elaine-ch/quadcopter/README.md

## Vortex 2024 Drone project


Video of it flying: [https://photos.app.goo.gl/hCnUwj7Pyiz6dDBa6](https://photos.app.goo.gl/hCnUwj7Pyiz6dDBa6)
