elaine-ch/quadcopter/hardware/quadcopter.brd

## EAGLE design hardware/quadcopter.brd (2024-11-07)

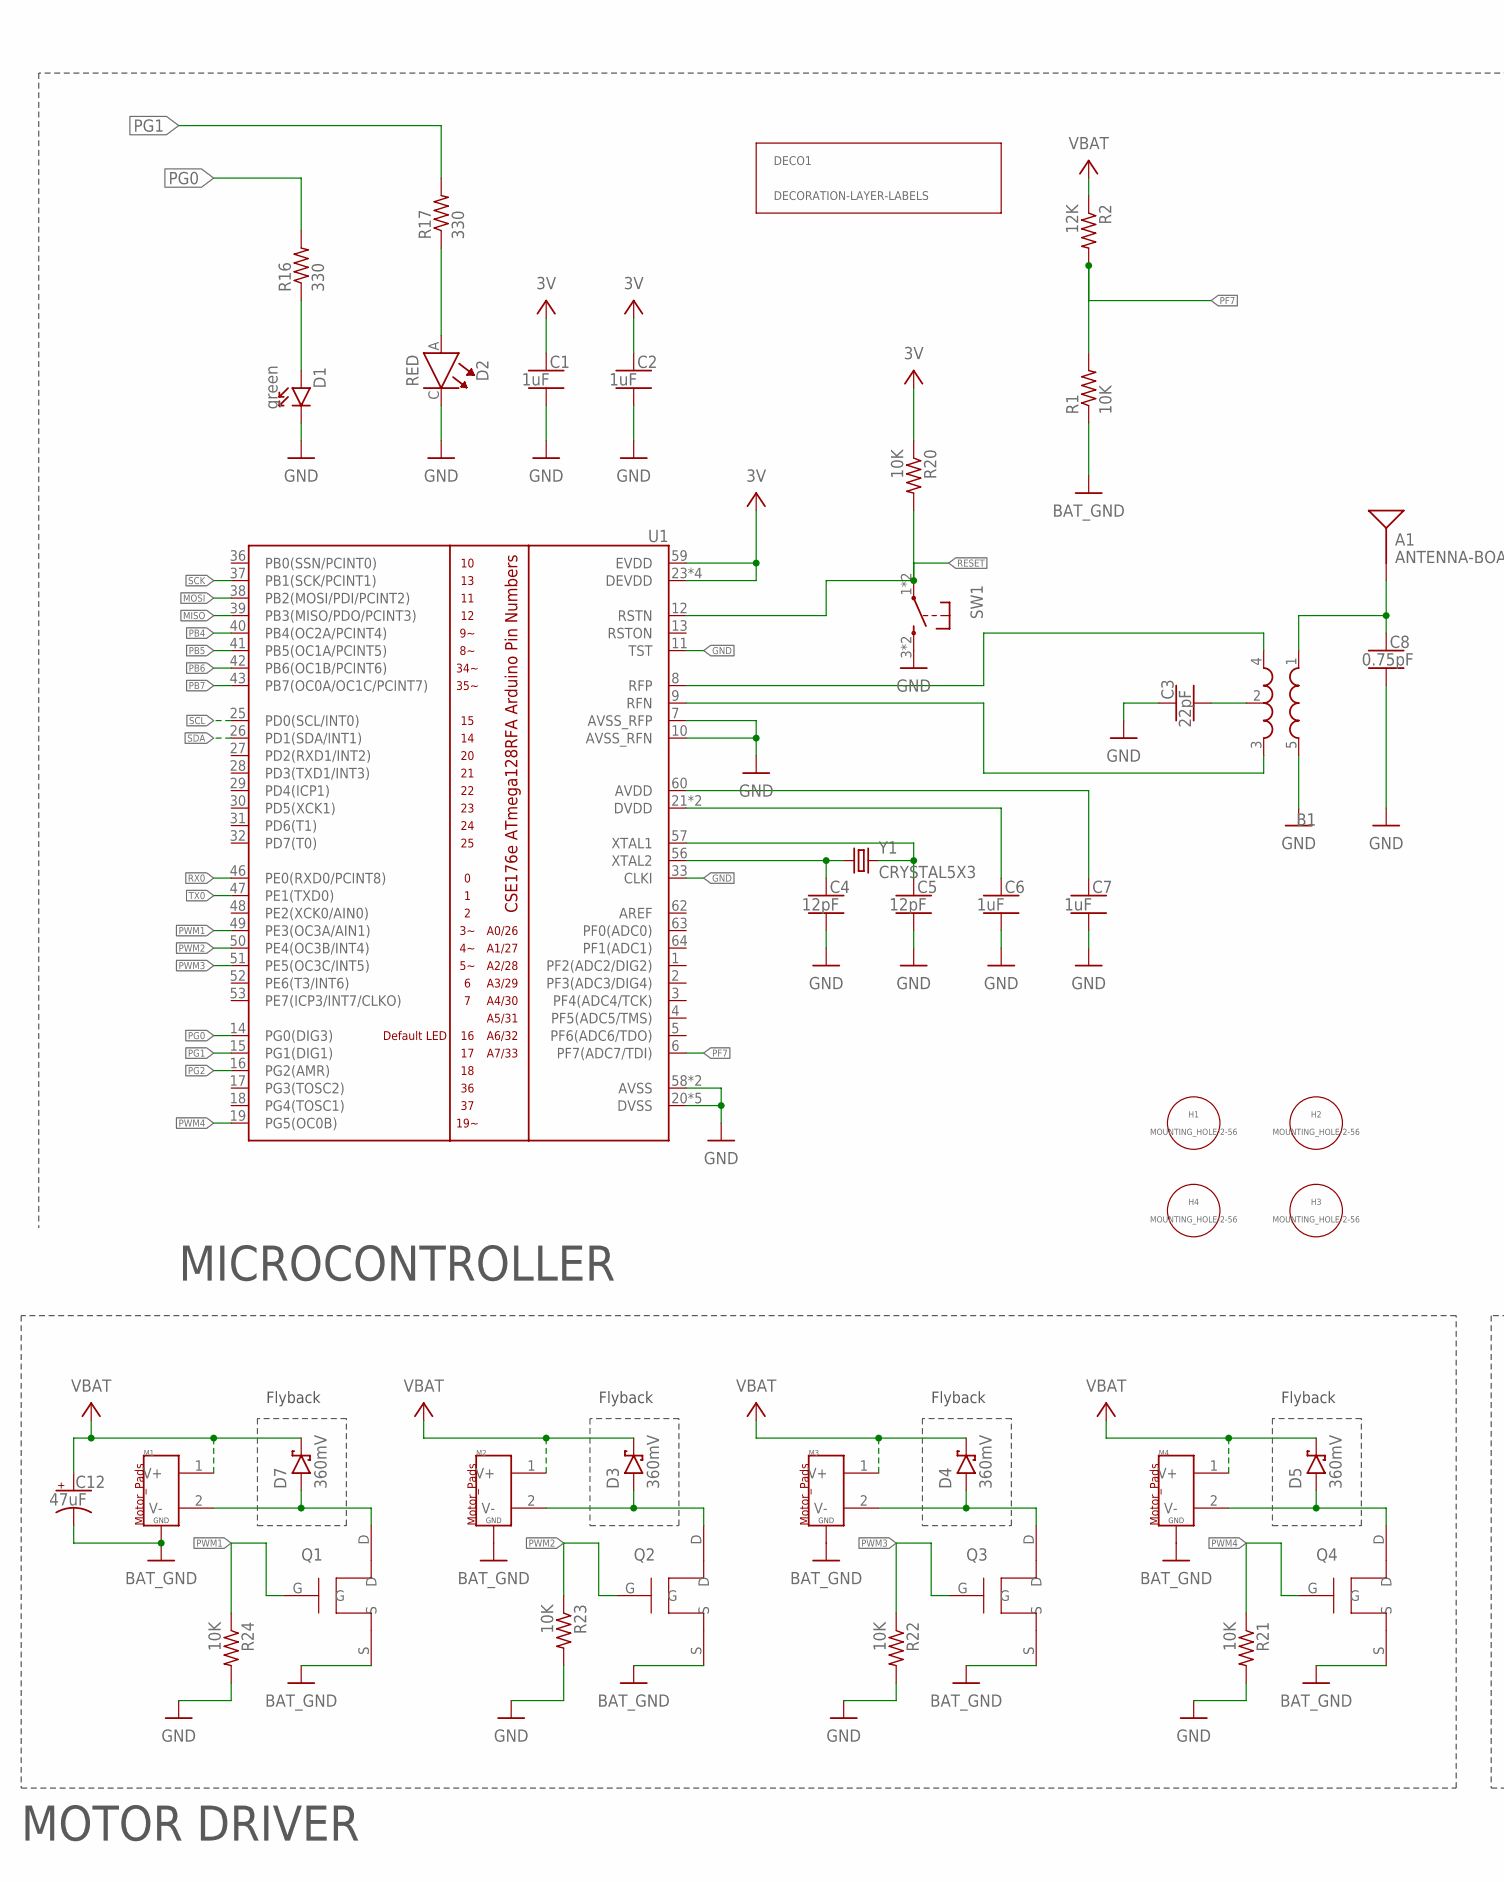
[picture p1: schematic quadcopter.sch, part in row 1, column 1]

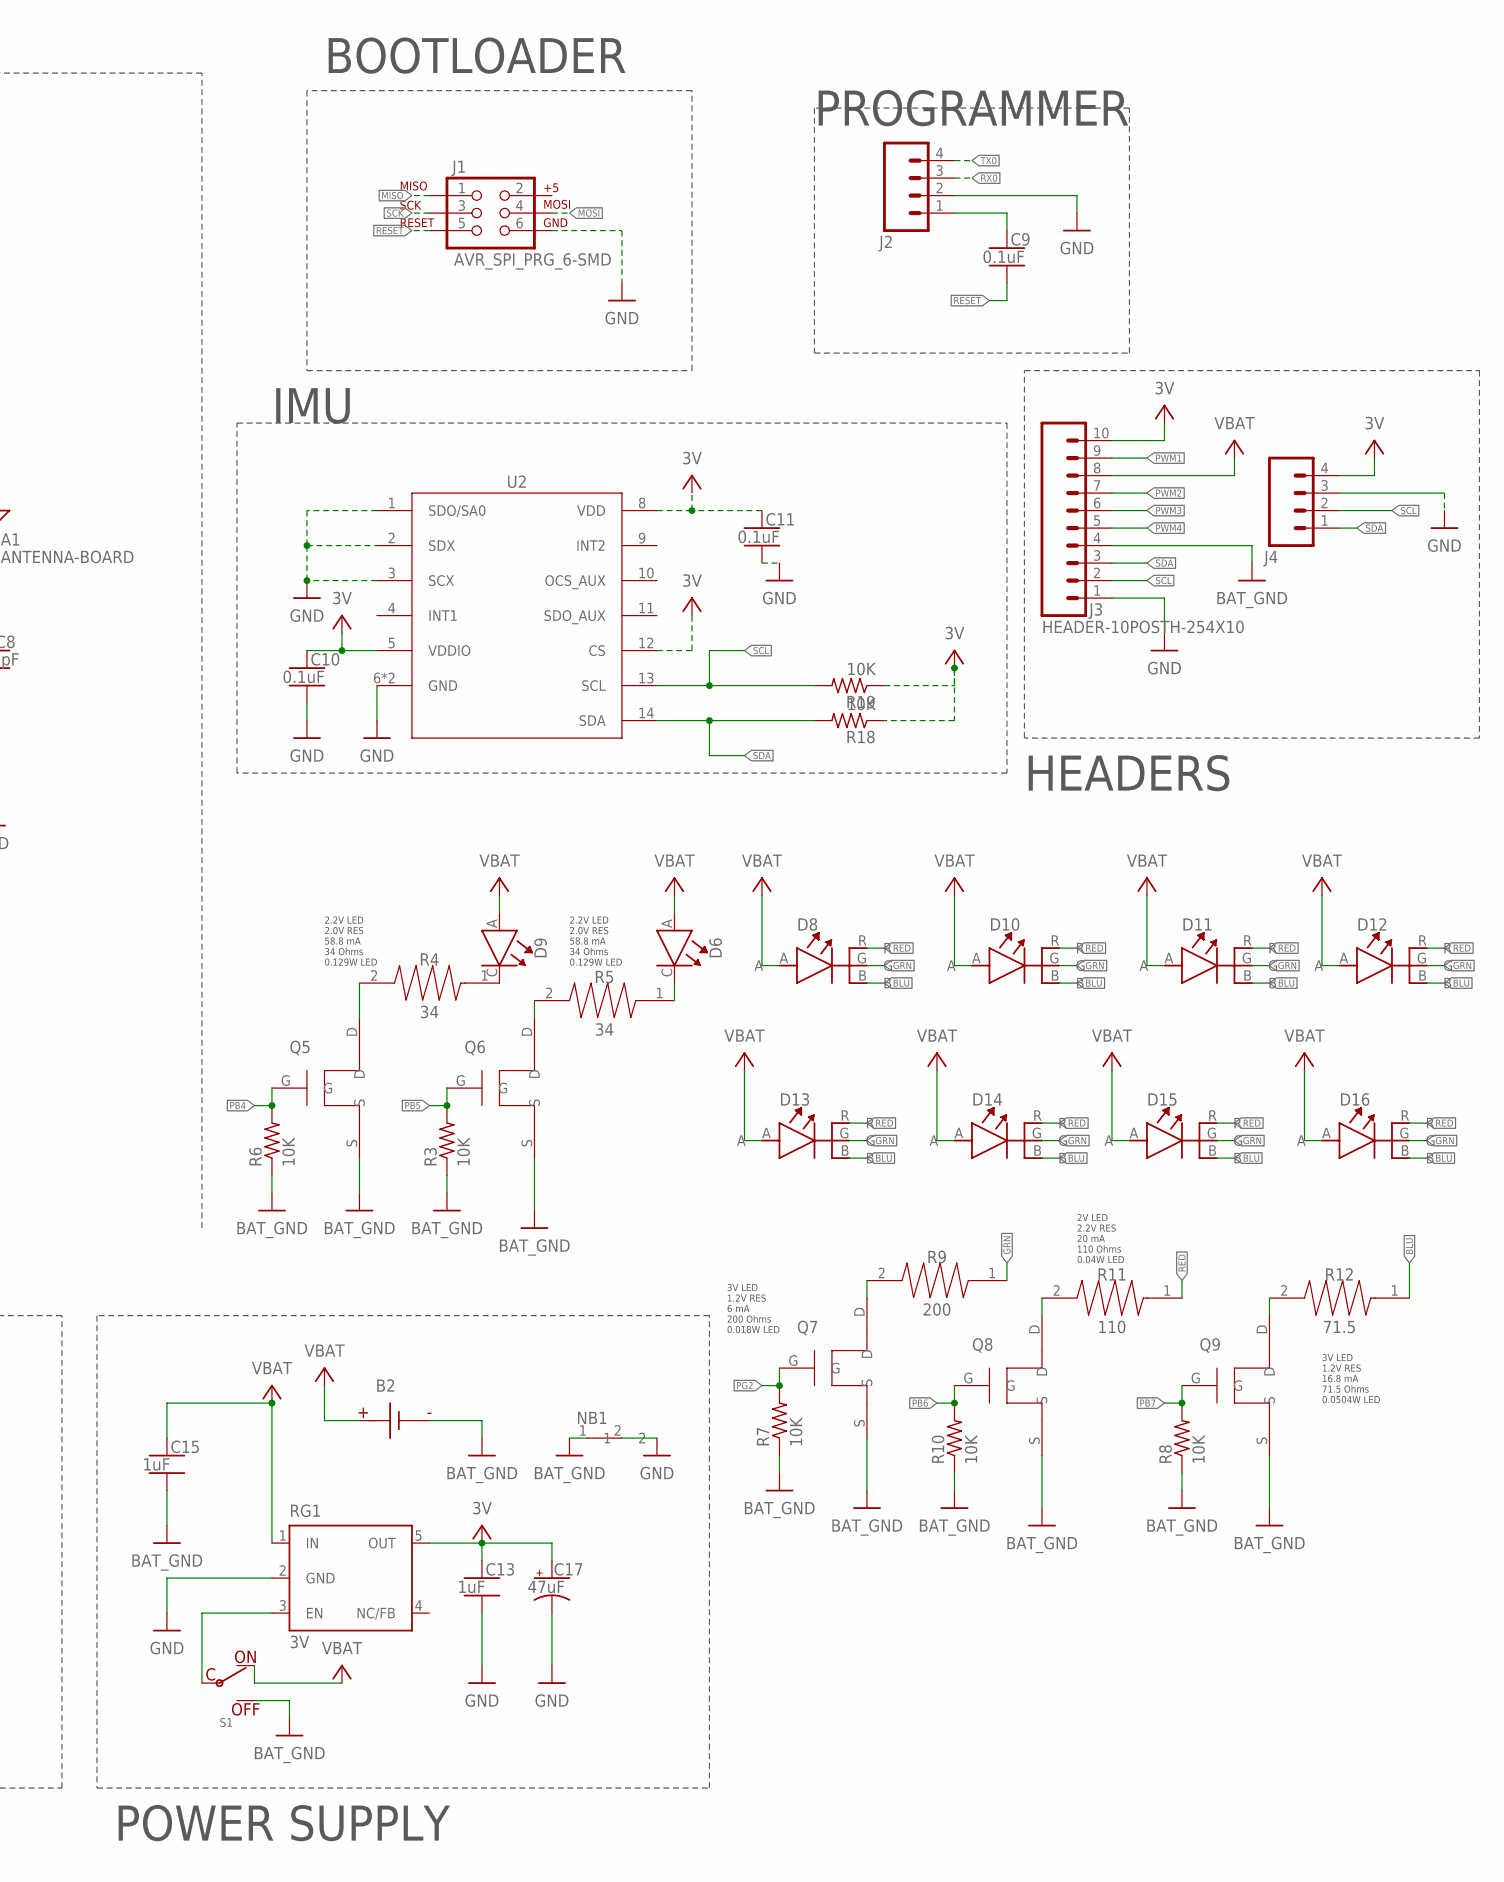
[picture p2: schematic quadcopter.sch, part in row 1, column 2]

Parts:
A1: ANTENNA-BOARD; ANT_PCB_2.4GHZ_NRF8001_1.6MM_1OZ
B1: BALUN0805; BALUN
B2: BATTERY-SCREW-TERMINAL; SCREW-TERMINAL-1X2-2.54MM
C1, C2, C6, C7, C13, C15: 1uF; CAPC2012X140_HS
C3: 22pF; CAPC2012X140_HS
C4, C5: 12pF; CAPC2012X140_HS
C8: 0.75pF; CAPC2012X140_HS
C9, C10, C11: 0.1uF; CAPC2012X140_HS
C12, C17: 47uF; CAPMP3216X180
D1: green; LEDSC125X200X120-2_HS
D2: RED; LEDC1507X80
D3, D4, D5, D7: 360mV; SODFL3516X96
D6, D9: LED-YELLOW-LED; LEDQLSP30YK
D8, D10, D11, D12, D13, D14, D15, D16: RGB-LED-DIFFUSE-LED; LED150080M153000
DECO1: DECORATION-LAYER-LABELS; LAYER_LABELS
H1, H2, H3, H4: MOUNTING_HOLE-2-56; 2-56-MOUNTING-HOLE-NO-METAL
J1: AVR_SPI_PRG_6-SMD; 2X3-SMD
J2, J4: HEADER-4POS-0.1IN-FEMALE-SMD-BOTTOM-ENTRY; HEADER-1X4-BOTTOM-ENTRY
J3: HEADER-10POSTH-254X10; HDRV10W63P254_10X1_2540X254H838_HS
M1, M2, M3, M4: MOTOR_PADS_GND-MOLEX-SMD; MOLEX-0532610271
NB1: NET-BRIDGE; NET_BRIDGE
Q1, Q2, Q3, Q4, Q5, Q6, Q7, Q8, Q9: MOSFET-SI2302CDS-T1-E3CT-ND; SOT95P240X110-3MOSFET
R1, R3, R6, R7, R8, R10, R18, R19, R20, R21, R22, R23, R24: 10K; RESC2012X60_HS
R2: 12K; RESC2012X60_HS
R4, R5: 34; 0805_RESISTOR
R9: 200; 0805_RESISTOR
R11: 110; 0805_RESISTOR
R12: 71.5; 0805_RESISTOR
R16, R17: 330; RESC2012X60_HS
RG1: 3V; SOT23-DBV
S1: POWER-SWITCH-MFS201N-9-Z-SMD-EDGE; JS102011SAQN
SW1: PUSHBUTTON_SMD-VERTICAL-1; TE_FSM8JSMA_HS
U1: ATMEGA128RFA1; QFN-64
U2: LSM-IMU-497-18367-1-NDIMU; LSM6DS0-IMU
Y1: CRYSTAL5X3; CRYSTAL-SMD-5X3

Connections:
3V: C1.1, C2.1, C10.1, C11.1, C13.1, C17.1 (+), J3.10, J4.4, R18.1, R19.1, R20.1, RG1.5 (OUT), U1.23 (DEVDD), U1.34 (DEVDD), U1.44 (DEVDD), U1.54 (DEVDD), U1.59 (EVDD), U2.5 (VDDIO), U2.8 (VDD), U2.12 (CS)
BAT_GND: B2.1 (N), C12.2 (-), C15.2, J3.4, M1.G1 (GND), M1.G2 (GND), M2.G1 (GND), M2.G2 (GND), M3.G1 (GND), M3.G2 (GND), M4.G1 (GND), M4.G2 (GND), NB1.1, Q1.S, Q2.S, Q3.S, Q4.S, Q5.S, Q6.S, Q7.S, Q8.S, Q9.S, R1.1, R3.1, R6.1, R7.1, R8.1, R10.1, S1.A (OFF)
BLU: D8.B, D10.B, D11.B, D12.B, D13.B, D14.B, D15.B, D16.B, R12.1
GND: B1.5 (GND), C1.2, C2.2, C3.1, C4.2, C5.2, C6.2, C7.2, C8.2, C10.2, C11.2, C13.2, C17.2 (-), D1.C, D2.C, J1.6, J2.2, J3.1, J4.3, NB1.2, R21.2, R22.2, R23.2, R24.2, RG1.2 (GND), SW1.3 (2), SW1.4 (2), U1.7 (AVSS_RFP), U1.10 (AVSS_RFN), U1.11 (TST), U1.20 (DVSS), U1.24 (DVSS), U1.33 (CLKI), U1.35 (DVSS), U1.45 (DVSS), U1.55 (DVSS), U1.58 (AVSS), U1.61 (AVSS), U2.1 (SDO/SA0), U2.2 (SDX), U2.3 (SCX), U2.6 (GND), U2.7 (GND)
GRN: D8.G, D10.G, D11.G, D12.G, D13.G, D14.G, D15.G, D16.G, R9.1
MISO: J1.1, U1.39 (PB3(MISO/PDO/PCINT3))
MOSI: J1.4, U1.38 (PB2(MOSI/PDI/PCINT2))
unnamed: D1.A, R16.1
unnamed: D2.A, R17.1
unnamed: B1.4 (OUT1), U1.8 (RFP)
unnamed: B1.3 (OUT2), U1.9 (RFN)
unnamed: B1.2 (GND), C3.2
unnamed: C5.1, U1.57 (XTAL1), Y1.3 (2)
unnamed: C4.1, U1.56 (XTAL2), Y1.1
unnamed: C7.1, U1.60 (AVDD)
unnamed: C6.1, U1.21 (DVDD), U1.22 (DVDD)
unnamed: A1.FEED, B1.1 (IN), C8.1
unnamed: C9.1, J2.1
unnamed: D9.C, R4.1
unnamed: Q6.D, R5.2
unnamed: D7.2 (A), M1.2 (V-), Q1.D
unnamed: D3.2 (A), M2.2 (V-), Q2.D
unnamed: D4.2 (A), M3.2 (V-), Q3.D
unnamed: D5.2 (A), M4.2 (V-), Q4.D
unnamed: D6.C, R5.1
unnamed: Q7.D, R9.2
unnamed: RG1.3 (EN), S1.C
unnamed: Q8.D, R11.2
unnamed: Q5.D, R4.2
unnamed: Q9.D, R12.2
PB4: Q5.G, R6.2, U1.40 (PB4(OC2A/PCINT4))
PB5: Q6.G, R3.2, U1.41 (PB5(OC1A/PCINT5))
PB6: Q8.G, R10.2, U1.42 (PB6(OC1B/PCINT6))
PB7: Q9.G, R8.2, U1.43 (PB7(OC0A/OC1C/PCINT7))
PF7: R1.2, R2.2, U1.6 (PF7(ADC7/TDI))
PG0: R16.2, U1.14 (PG0(DIG3))
PG1: R17.2, U1.15 (PG1(DIG1))
PG2: Q7.G, R7.2, U1.16 (PG2(AMR))
PWM1: J3.9, Q1.G, R24.1, U1.49 (PE3(OC3A/AIN1))
PWM2: J3.7, Q2.G, R23.1, U1.50 (PE4(OC3B/INT4))
PWM3: J3.6, Q3.G, R22.1, U1.51 (PE5(OC3C/INT5))
PWM4: J3.5, Q4.G, R21.1, U1.19 (PG5(OC0B))
RED: D8.R, D10.R, D11.R, D12.R, D13.R, D14.R, D15.R, D16.R, R11.1
RESET: C9.2, J1.5, R20.2, SW1.1, SW1.2 (1), U1.12 (RSTN)
RX0: J2.3, U1.46 (PE0(RXD0/PCINT8))
SCK: J1.3, U1.37 (PB1(SCK/PCINT1))
SCL: J3.2, J4.2, R19.2, U1.25 (PD0(SCL/INT0)), U2.13 (SCL)
SDA: J3.3, J4.1, R18.2, U1.26 (PD1(SDA/INT1)), U2.14 (SDA)
TX0: J2.4, U1.47 (PE1(TXD0))
VBAT: B2.2, C12.1 (+), C15.1, D3.1 (C), D4.1 (C), D5.1 (C), D6.A, D7.1 (C), D8.A, D9.A, D10.A, D11.A, D12.A, D13.A, D14.A, D15.A, D16.A, J3.8, M1.1 (V+), M2.1 (V+), M3.1 (V+), M4.1 (V+), R2.1, RG1.1 (IN), S1.B (ON)

Notes on the sheet:
MICROCONTROLLER
BOOTLOADER
PROGRAMMER
Flyback
MOTOR DRIVER
POWER SUPPLY
2.2V LED 2.0V RES 58.8 mA 34 Ohms 0.129W LED
IMU
HEADERS
3V LED 1.2V RES 6 mA 200 Ohms 0.018W LED
3V LED 1.2V RES 16.8 mA 71.5 Ohms 0.0504W LED
2V LED 2.2V RES 20 mA 110 Ohms 0.04W LED

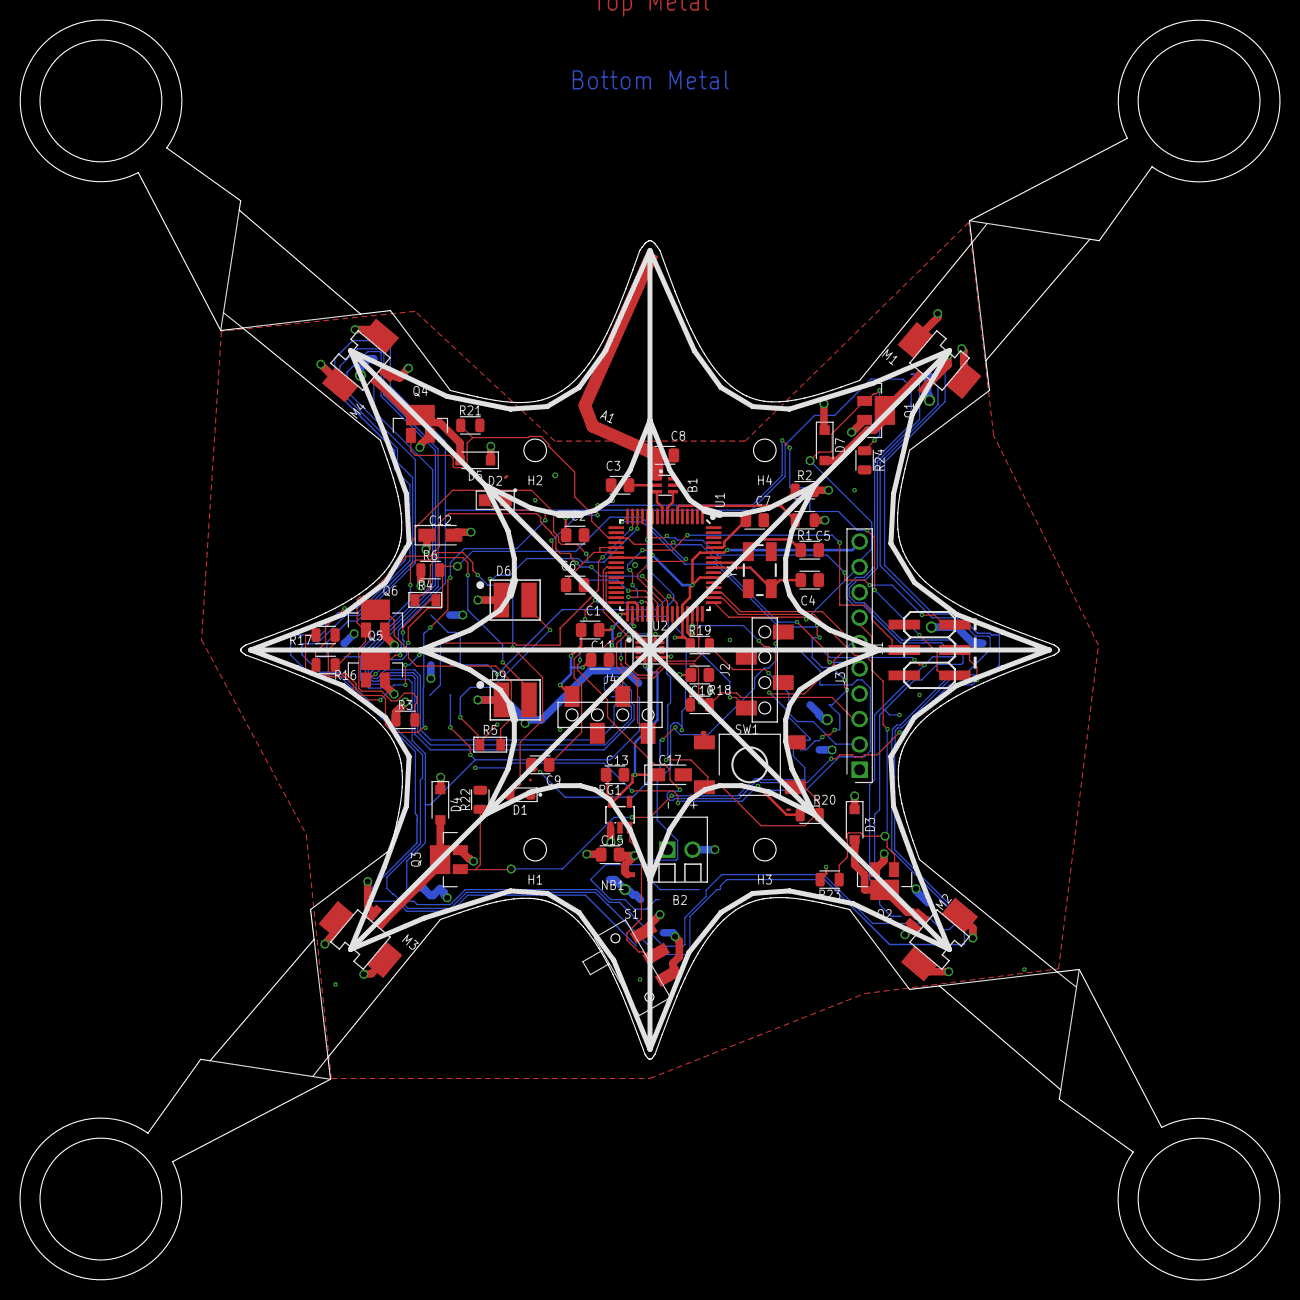
[picture p3: board quadcopter.brd from above]

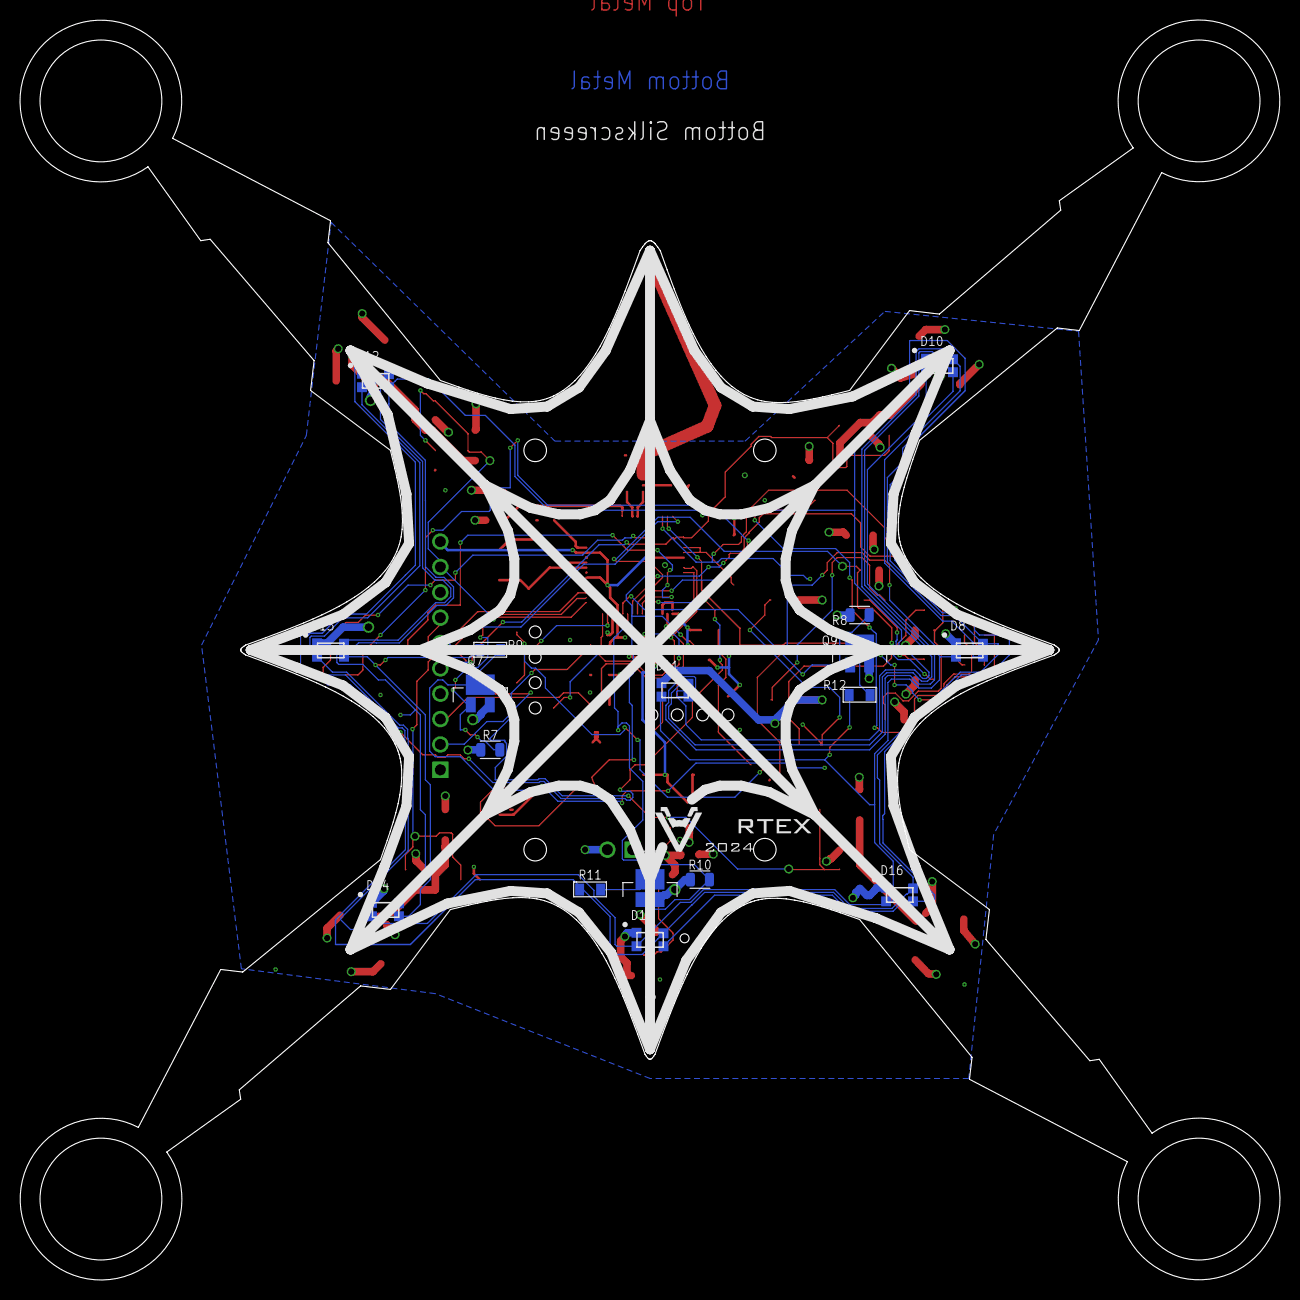
[picture p4: board quadcopter.brd from below]

Board: 4 copper layers, 126.2 x 126.2 mm, 85 parts (18 on the bottom side), 50 nets.

Other parts of the board:
LG1: VORTEX-LOGO
