elaine-ch/quadcopter/firmware/RFChat/RFChat.ino

#include "radio.h"

void setup()
{
  Serial.begin(9600);  // Start up serial
  rfBegin(12);  // Initialize ATmega128RFA1 radio on channel 11 (can be 11-26)
  
  // Send a message to other RF boards on this channel
  rfPrint("ATmega128RFA1 Dev Board Online!\r\n");
}

void loop()
{
  uint8_t b[256];
  int len;
  if (len = rfAvailable())  // If serial comes in...
  {
    rfRead(b, len);
    b[len] = 0;
    Serial.write((char *)b);
  }

  if (len = Serial.available()) {
    for (int i = 0; i < len; i++) {
      b[i] = Serial.read(); 
    }
    rfWrite(b, len); // ...send it out the radio.
  }
}
