elaine-ch/quadcopter/(commit log)

2024-10-10 added throttle serial print
2024-10-15 fixed battery levels
2024-10-15 display battery levels on LCD
2024-10-17 Lab 3
    [quadcopter_v18.sch]
2024-10-18 tried fixing the warnings
    [quadcopter.sch]
2024-10-18 updated libraries and renamed custom for submit
    [quadcopter.sch]
2024-10-18 removed extra pins
    [quadcopter.sch]
2024-10-18 switched gnd to gnd and removed VDDIO tag
    [quadcopter.sch]
2024-10-18 renamed motors
    [quadcopter.sch]
2024-10-18 fixed vddio capacitance
    [quadcopter.sch]
2024-10-18 IMU capacitances fixed?
    [quadcopter.sch]
2024-10-18 renamed net bridge
    [quadcopter.sch]
2024-10-18 fixed power supply?
    [quadcopter.sch]
2024-10-18 fixed VDDIO error hopefully
    [quadcopter.sch]
2024-10-18 attempt to fix power supply
    [quadcopter.sch]
2024-10-18 2 new resistors
    [quadcopter.sch]
2024-10-18 resistors fixed with variants
    [quadcopter.sch]
2024-10-19 changed actual library name
    [quadcopter.sch]
2024-10-19 actually made the library name changes for real this time
    [quadcopter.sch]
2024-10-19 got rid of library
    [quadcopter.sch]
2024-10-19 did git reset --hard and then exported to fix battery again
    [quadcopter.sch]
2024-10-19 changed imu connection
    [quadcopter.sch]
2024-10-19 fixed n
    [quadcopter.sch]
2024-10-19 added VDDIO connection to actual VDDIO
    [quadcopter.sch]
2024-10-19 switched pull up on SCL and SDA from 'VDDIO' to 3V
    [quadcopter.sch]
2024-10-19 moved polarized capacitor by Regulator to regulated side and made out the 3V
    [quadcopter.sch]
2024-10-19 redid VDDIO
    [quadcopter.sch]
2024-10-19 renamed motor pads because mosfet is complaining?
    [quadcopter.sch]
2024-10-19 removed 3 mosfets and motor pads
    [quadcopter.sch]
2024-10-19 replaced motors
    [quadcopter.sch]
2024-10-19 replaced motor pads and mosfets fulls
    [quadcopter.sch]
2024-10-19 replaced flyback diodes
    [quadcopter.sch]
2024-10-19 why :((
    [quadcopter.sch]
2024-10-19 renamed motor pads
    [quadcopter.sch]
2024-10-19 replaced all custom resistors and parts
    [quadcopter.sch]
2024-10-19 added schematic oops
    [quadcopter.sch]
2024-10-19 local leds
    [quadcopter.sch]
2024-10-19 fixed errors
    [quadcopter.sch]
2024-10-19 fixed diode
    [quadcopter.sch]
2024-10-19 got rid of extra 2 1K resistors in voltage divider as suggested
    [quadcopter.sch]
2024-10-20 replaced sch to push
    [quadcopter.sch]
2024-10-20 fixed LED resistor values
    [quadcopter.sch]
2024-10-20 34 ohm resistors for LEDs
    [quadcopter.sch]
2024-10-22 sensor plotting not working
    [quad_firmware.ino]
2024-10-24 fixed get orientation issues
    [quad_firmware.ino, remote_firmware.ino]
2024-10-27 added RGB LEDs
    [quadcopter.sch]
2024-11-01 fixed quick check
    [quadcopter.brd]
2024-11-02 fixed quickcheck part 2
    [quadcopter.brd, quadcopter.sch]
2024-11-02 changed part names
    [quadcopter.brd, quadcopter.sch]
2024-11-03 fixed full check issues
    [quadcopter.brd, quadcopter.sch]
2024-11-05 complimentary filter attempt 1
2024-11-05 finished fixing review
    [quadcopter.brd, quadcopter.sch]
2024-11-05 fixed quick check 2
    [quadcopter.brd]
2024-11-05 fixed full check
    [quadcopter.brd, quadcopter.sch]
2024-11-05 FIXED THE CAPACITORS JESUS CHRIST
    [quadcopter.brd]
2024-11-05 human error fixes and cam export
    [quadcopter.brd]
2024-11-06 one motor goes and 3 are full power or minimal power
2024-11-07 added pid set constants, need PID equations still. untested
2024-11-07 tapeout quick check update
    [quadcopter.brd]
2024-11-07 pid tuning available, no registers set, no pid actual control. cf filter appears to work
2024-11-10 implemented PID control for yaw and pitch part 1
2024-11-10 PID control fix iTerms and throttle off turns it off
    [quad_firmware.ino]
2024-11-10 can do pid while armed and print pitch
2024-11-11 new fancy PID controls
2024-11-11 fancy PID Controls fixed (I hope)
    [remote_firmware.ino]
2024-11-11 flipped enc1 and button1 prev pushed
    [remote_firmware.ino]
2024-11-11 can now exit PID calbration mode
2024-11-11 figured out actual correction direction
    [quad_firmware.ino]
2024-11-11 constrained setting motors to between 0 and 255
2024-11-11 for leaving PID Cal mode. set button to pressed and return
2024-11-11 fix entering PID Cal Mode
    [remote_firmware.ino]
2024-11-11 fixed entering/exiting pid mode
    [remote_firmware.ino]
2024-11-12 adding PID while armed not working
    [quad_firmware.ino, remote_firmware.ino]
2024-11-12 working on yaw
2024-11-12 got yaw working
2024-11-12 pitch working
2024-11-12 yaw working, pitch weird
2024-12-03 added roll and pin assignments
2024-12-09 flipped roll to be intuitive
    [remote_firmware.ino]
2024-12-10 made rgb LEDs glow
